jdc-cunningham/modular-pi-cam/README.md

### Modular Pi Cam

### Ver 2 (2.4in rectangle display)

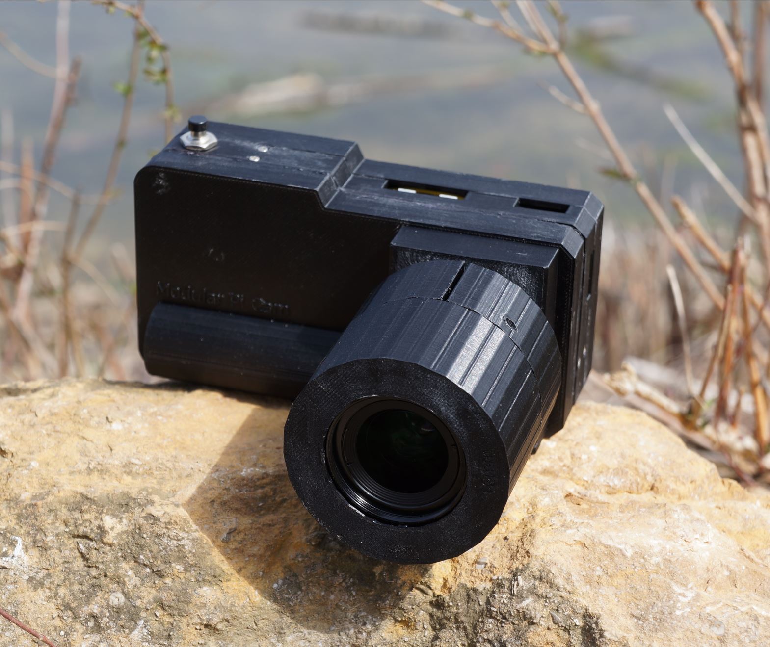
[picture p1: modular-pi-cam.JPG]


### Ver 1 (1.28 round display)

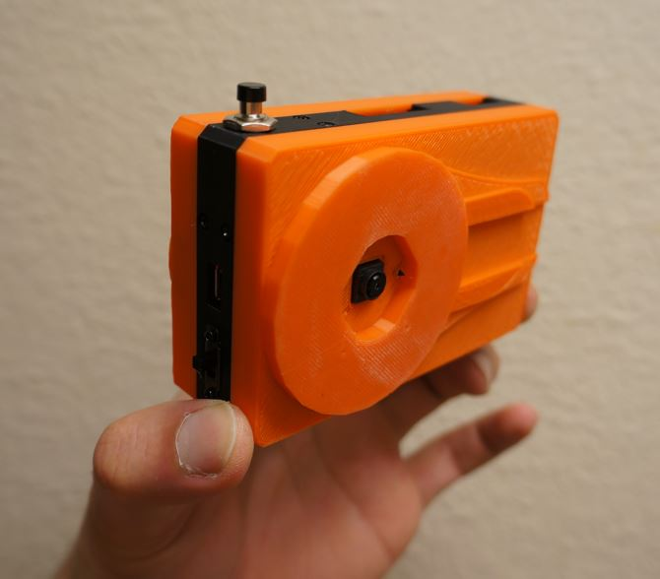
[picture p2: iso-front.JPG]


This version uses round display (non-touch) with 5D joystick

### Modularity

The center piece has changeable back and front plates
