jdc-cunningham/modular-pi-cam/cameras/pi-zero/large-display/README.md

### 2.4" LCD Display

Swappable cameras and body plates

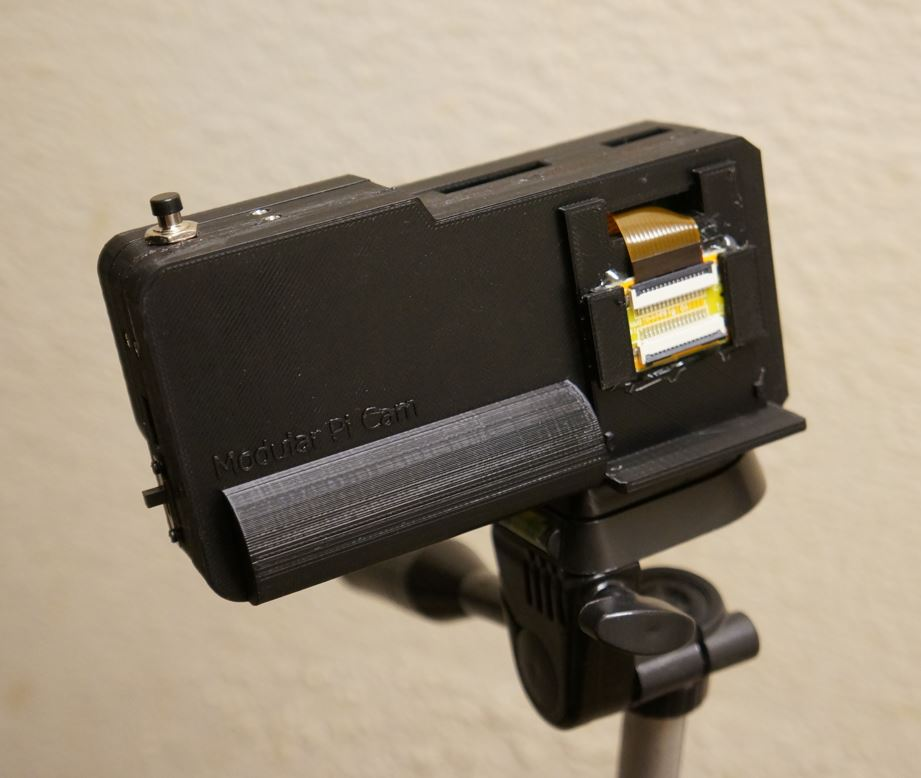
[picture p3: cameras/pi-zero/large-display/bridge-pin.JPG]


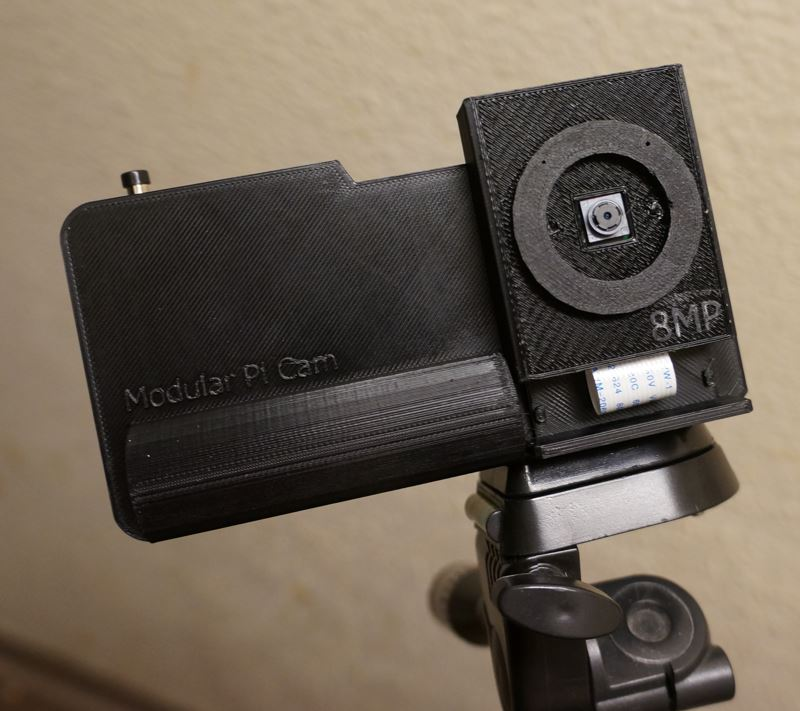
[picture p4: cameras/pi-zero/large-display/non-hq-cam.JPG]


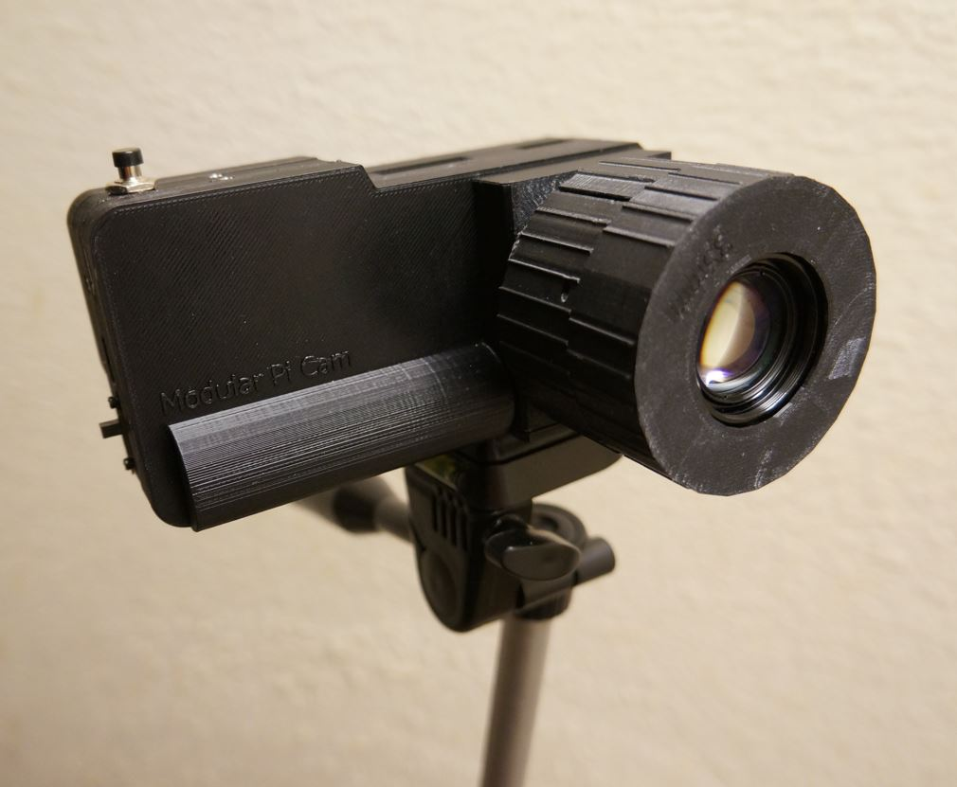
[picture p5: cameras/pi-zero/large-display/front.JPG]


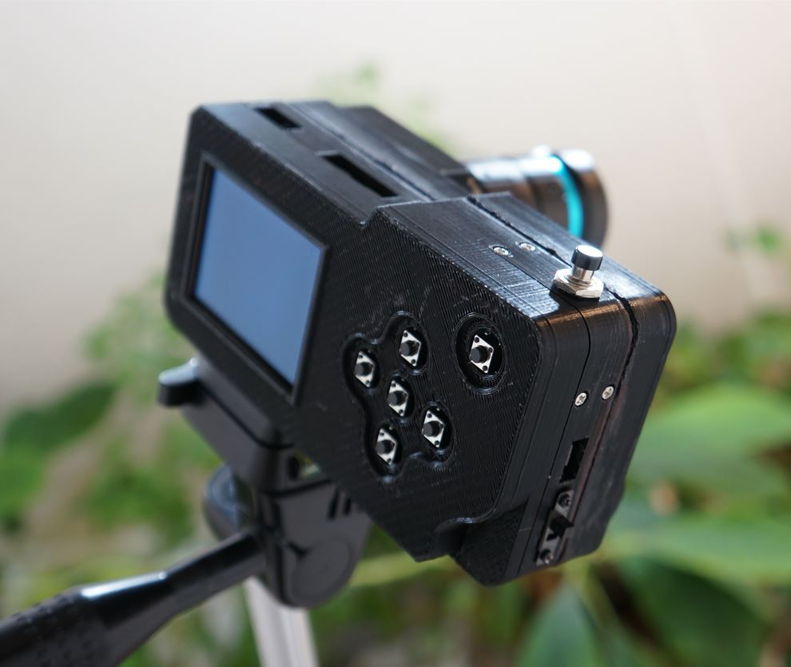
[picture p6: cameras/pi-zero/large-display/back-iso.JPG]
