jdc-cunningham/modular-pi-cam/cameras/pi-zero/pi-ro-cam/README.md

### Pi Ro Cam

Round display camera

Swappable body plates

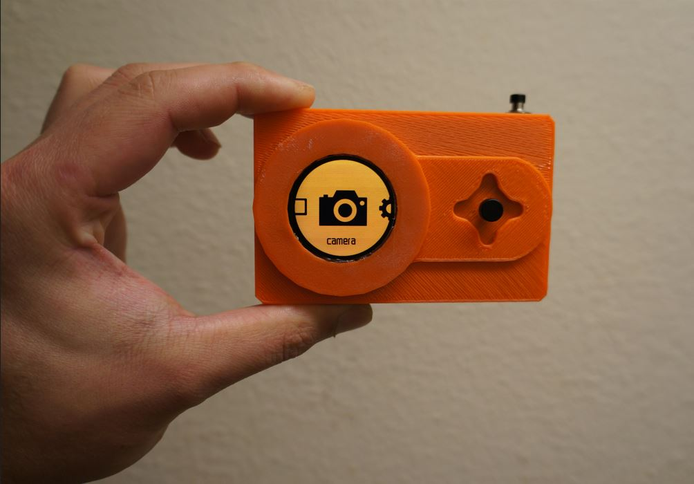
[picture p7: cameras/pi-zero/pi-ro-cam/modular-pi-cam-lcd.JPG]


### About

This was the first version, much smaller than the newer version that can swap camera modules vs. face plates.

The newer version is also much larger and features a tripod bolt screw mount.
