jdc-cunningham/modular-pi-cam/cameras/pi-zero/large-display/hardware/README.md

### Parts list

- raspberry pi zero 2 w
  - https://www.pishop.us/product/raspberry-pi-zero-2-w/
- raspberry pi hq cam
  - https://www.adafruit.com/product/4561
- 16mm telephoto lens
  - https://www.adafruit.com/product/4562
- DC-DC boost converter
  - [very long link](https://www.amazon.com/Converter-Adjustable-Voltage-Regulator-Compatible/dp/B089JYBF25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)
- 18650 battery
  - https://www.18650batterystore.com/products/panasonic-ncr18650b
- waveshare 2.4" LCD display
  - https://www.amazon.com/dp/B08H24H7KX?psc=1&ref=ppx_yo2ov_dt_b_product_details
  - https://www.waveshare.com/2.4inch-lcd-module.htm
- tactile button
  - https://www.amazon.com/gp/product/B07VSNN9S2/ref=ppx_yo_dt_b_search_asin_title?ie=UTF8&psc=1
- shutter button
  - https://www.amazon.com/gp/product/B09DJY5Y5L/ref=ppx_yo_dt_b_search_asin_title?ie=UTF8&psc=1
- 1 cell BMS/charger
  - https://www.amazon.com/gp/product/B00LTQU2RK/ref=ppx_yo_dt_b_search_asin_title?ie=UTF8&psc=1
- proto PCB board (cut to size)
  - https://www.amazon.com/gp/product/B072Z7Y19F/ref=ppx_yo_dt_b_search_asin_title?ie=UTF8&psc=1
- soft wire
  - https://www.amazon.com/gp/product/B01LH1G2IE/ref=ppx_yo_dt_b_search_asin_title?ie=UTF8&psc=1
- switch
  - https://www.amazon.com/gp/product/B01N235HVR/ref=ppx_yo_dt_b_search_asin_title?ie=UTF8&psc=1
- screws (used M1.7*6)
  - https://www.amazon.com/gp/product/B07HF46Q4R/ref=ppx_yo_dt_b_search_asin_title?ie=UTF8&psc=1
- otg usb
  - https://www.amazon.com/dp/B083WML1XB?psc=1&ref=ppx_yo2ov_dt_b_product_details
- usb mic
  - https://www.amazon.com/gp/product/B074BLM973/ref=ppx_yo_dt_b_search_asin_title?ie=UTF8&psc=1
- 15 pin extender for camera
  - https://www.amazon.com/gp/product/B07RWF4QCY/ref=ppx_yo_dt_b_search_asin_title?ie=UTF8&psc=1
- 15 pin type a cable needed for above
  - https://www.amazon.com/gp/product/B07RWTC13Q/ref=ppx_yo_dt_b_search_asin_title?ie=UTF8&psc=1

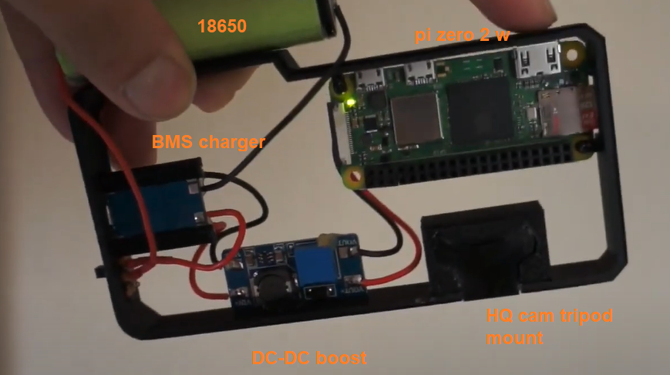
[picture p8: cameras/pi-zero/large-display/hardware/annotated.png]


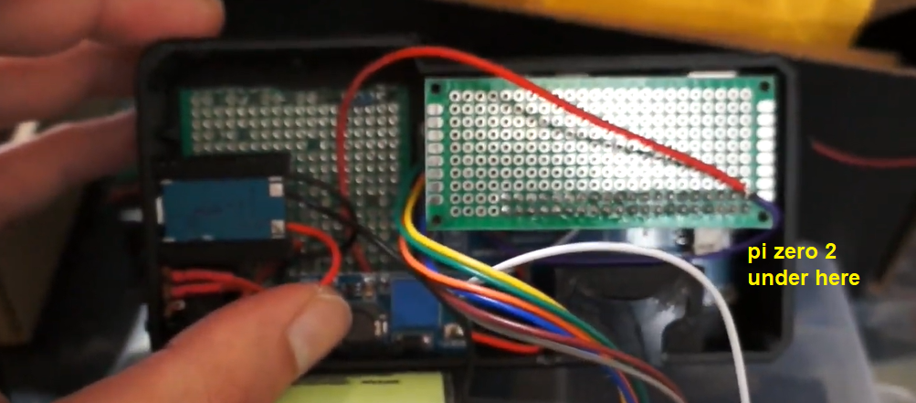
[picture p9: cameras/pi-zero/large-display/hardware/internals.png]
