jdc-cunningham/modular-pi-cam/cameras/pi-zero/pi-ro-cam/body/README.md

## Pi Ro Cam

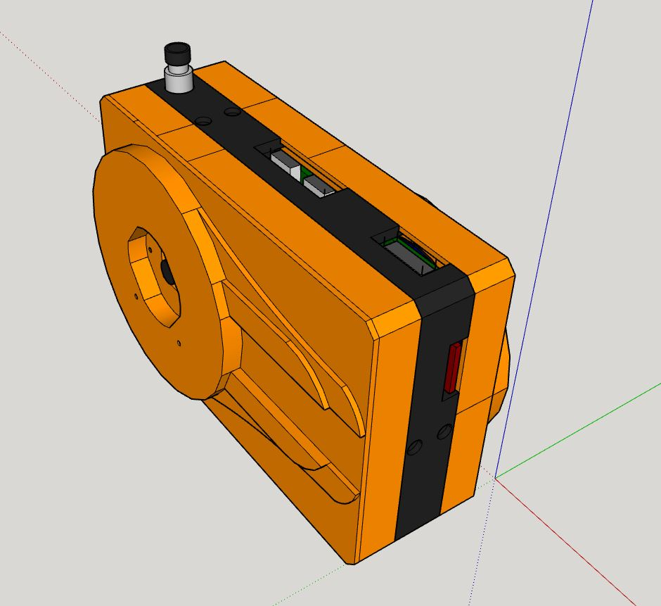
[picture p15: cameras/pi-zero/pi-ro-cam/body/iso.JPG]


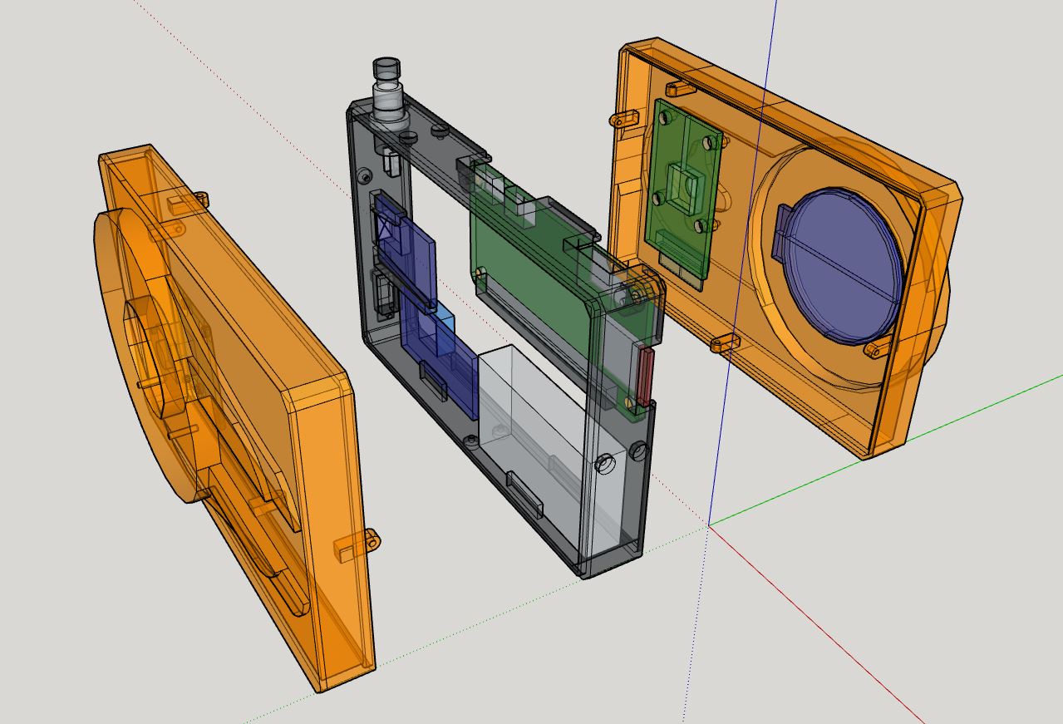
[picture p16: cameras/pi-zero/pi-ro-cam/body/exploded-xray.JPG]


### Print times

PLA 200C 50 mm/s 20% infill 1.75mm

- 2hrs 24mins middle body
- 3hrs 41mins back plate
- 4hrs 16mins v2 module front plate
