jdc-cunningham/modular-pi-cam/cameras/pi-zero/large-display/software/camera/README.md

### About

The Raspberry Pi HQ Camera has a 5.5 crop factor apparently so a 5mm CCTV lens is equivalent to 27.5mm full frame

picamera2 is primarily what is being used to do the live preview/photo taking
