jdc-cunningham/modular-pi-cam/cameras/pi-zero/large-display/software/FEATURES.md

### Implemented
- take auto setting photo
- take auto setting video
- crop-zoom pan (4x only)
- access IMU values (only 6050 part)
- demo file view
- battery estimator (software)

### Future
- manual camera settings
- dynamic battery icon (25%, 50%, 75%, 100%)
- crop-zoom pan (16x)
- redo menu organization/state management
- use IMU for horizontal overlay, maybe dead reckoning
- full working file view (background job to make thumbnails, pagination, individual view, delete)
- mobile app for bt file transfer/photo view on phone
- mobile remote shutter would be nice too
- astrophotography settings
