jdc-cunningham/modular-pi-cam/cameras/pi-zero/pi-ro-cam/modular-pi-cam-passthrough.JPG

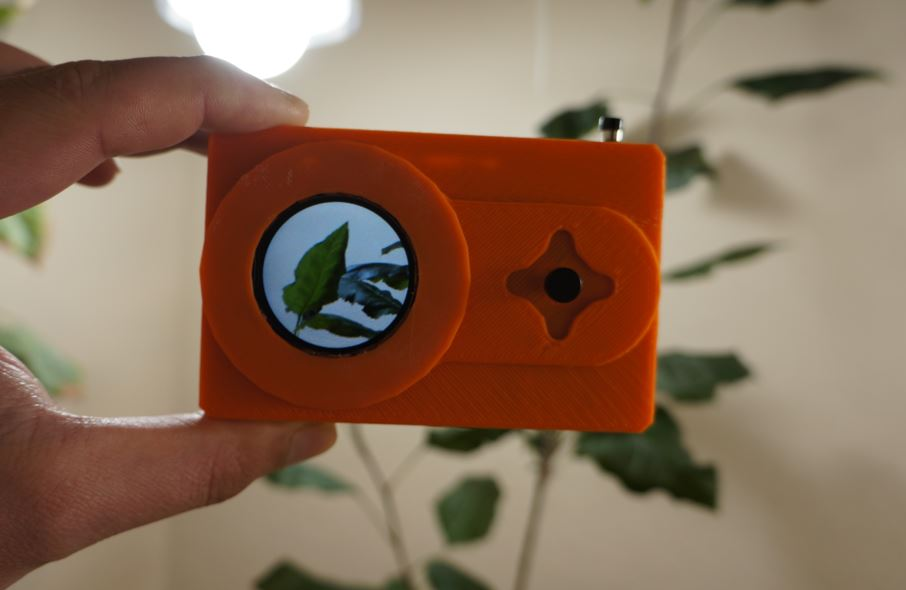
cameras/pi-zero/pi-ro-cam/modular-pi-cam-passthrough.JPG
