jdc-cunningham/modular-pi-cam/cameras/pi-zero/pi-ro-cam/software/display/pic/LCD_2inch4.jpg

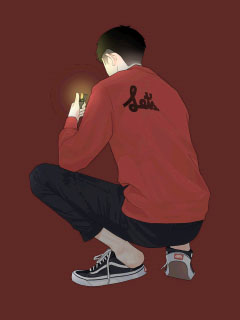
cameras/pi-zero/pi-ro-cam/software/display/pic/LCD_2inch4.jpg
