jdc-cunningham/modular-pi-cam/cameras/pi-zero/pi-ro-cam/software/menu/sprites/base-blue-gradient.png

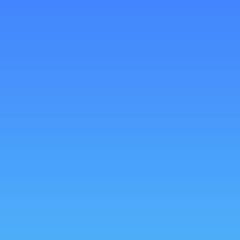
cameras/pi-zero/pi-ro-cam/software/menu/sprites/base-blue-gradient.png
