jdc-cunningham/modular-pi-cam/cameras/pi-zero/pi-ro-cam/software/menu/sprites/film_120_131.png

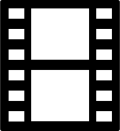
cameras/pi-zero/pi-ro-cam/software/menu/sprites/film_120_131.png
