jdc-cunningham/modular-pi-cam/cameras/pi-zero/pi-ro-cam/software/menu/sprites/settings_120_120.png

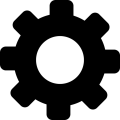
cameras/pi-zero/pi-ro-cam/software/menu/sprites/settings_120_120.png
