jdc-cunningham/modular-pi-cam/cameras/pi-zero/large-display/body/stls/usb-otg-cable-holder.stl

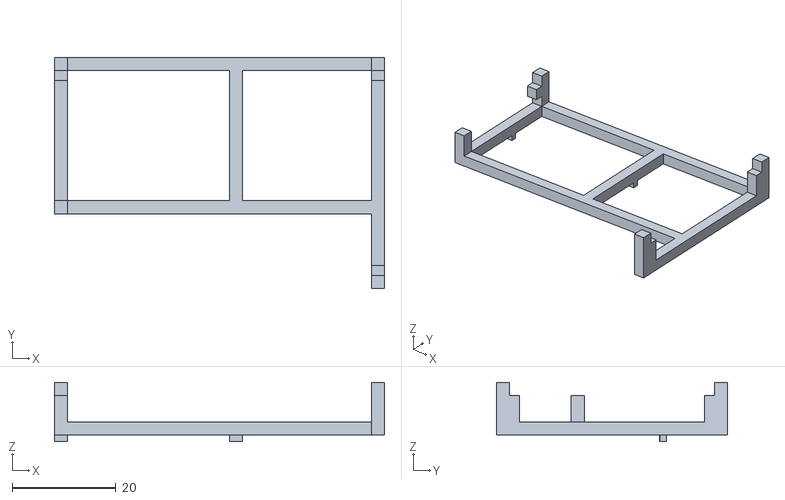
[picture p28: CAD file, 2024-06-11]
cameras/pi-zero/large-display/body/stls/usb-otg-cable-holder.stl
63.5 x 44.5 x 11.4
