jdc-cunningham/modular-pi-cam/cameras/pi-zero/pi-ro-cam/body/stls/back-plate-body.stl

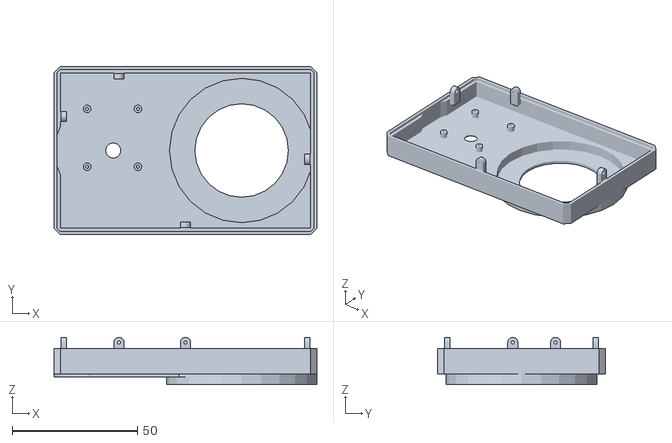
[picture p29: CAD file, 2024-03-14]
cameras/pi-zero/pi-ro-cam/body/stls/back-plate-body.stl
105.1 x 67.2 x 18.9
