jdc-cunningham/modular-pi-cam/cameras/pi-zero/large-display/body/stls/16mm-lens-cap.stl

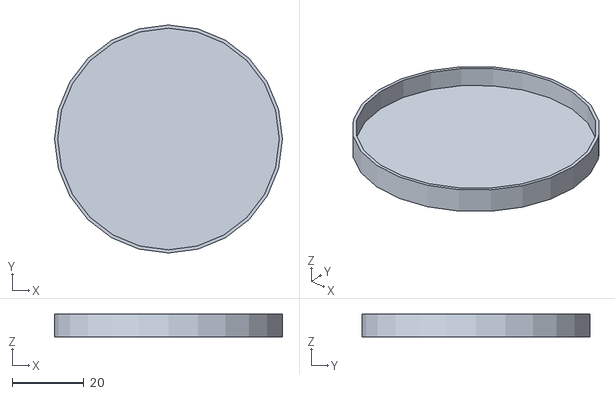
[picture p30: CAD file, 2024-03-27]
cameras/pi-zero/large-display/body/stls/16mm-lens-cap.stl
63.4 x 63.4 x 6.35
