jdc-cunningham/modular-pi-cam/cameras/pi-zero/pi-ro-cam/body/stls/front-plate-body-v2-cam-module.stl

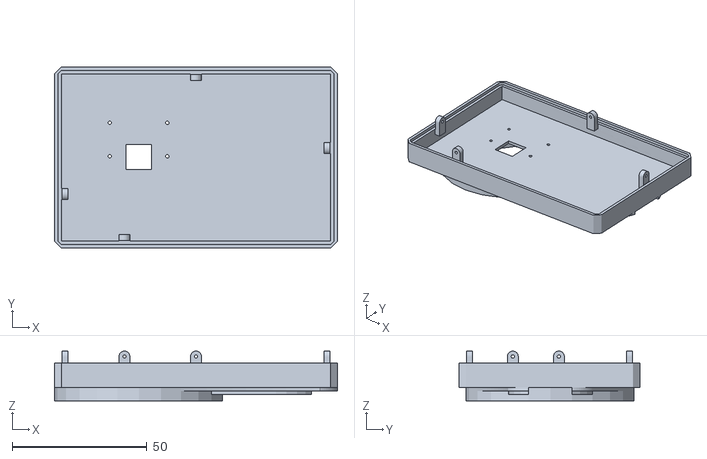
[picture p31: CAD file, 2024-03-14]
cameras/pi-zero/pi-ro-cam/body/stls/front-plate-body-v2-cam-module.stl
105.1 x 67.2 x 18.5
