jdc-cunningham/modular-pi-cam/cameras/pi-zero/large-display/body/stls/16mm-aperture-ring.stl

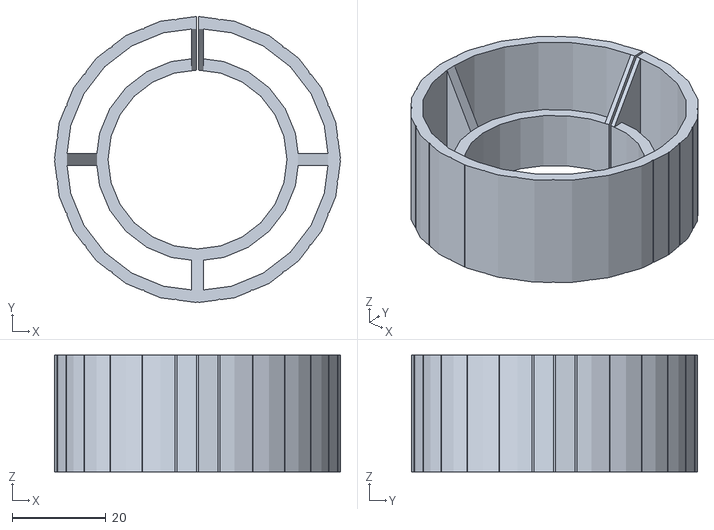
[picture p32: CAD file, 2024-03-27]
cameras/pi-zero/large-display/body/stls/16mm-aperture-ring.stl
60.9 x 60.9 x 24.9
