jdc-cunningham/modular-pi-cam/cameras/pi-zero/pi-ro-cam/body/stls/middle-body.stl

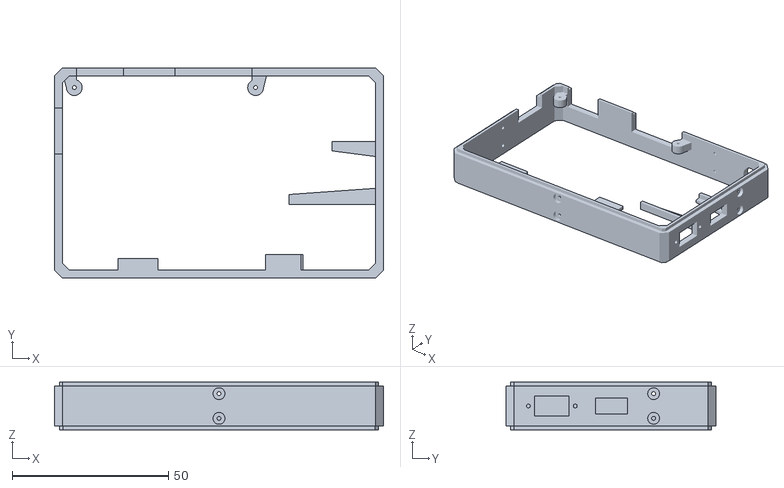
[picture p33: CAD file, 2024-03-14]
cameras/pi-zero/pi-ro-cam/body/stls/middle-body.stl
105.1 x 67.2 x 15.2
