jdc-cunningham/modular-pi-cam/cameras/pi-zero/large-display/body/stls/v3-module-cap.stl

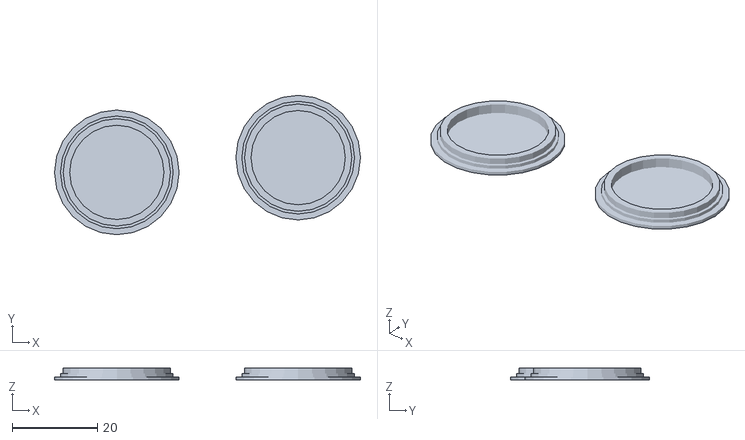
[picture p34: CAD file, 2024-03-27]
cameras/pi-zero/large-display/body/stls/v3-module-cap.stl
71.7 x 32.7 x 2.92
