jdc-cunningham/modular-pi-cam/cameras/pi-zero/large-display/body/stls/16m-focus-ring.stl

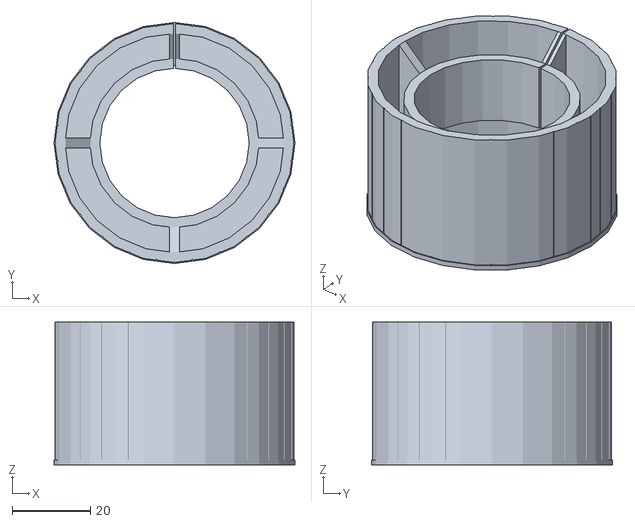
[picture p35: CAD file, 2024-03-27]
cameras/pi-zero/large-display/body/stls/16m-focus-ring.stl
61.5 x 61.5 x 36.5
