jdc-cunningham/modular-pi-cam/cameras/pi-zero/large-display/body/stls/v3-ring-slide-mount-top-plate.stl

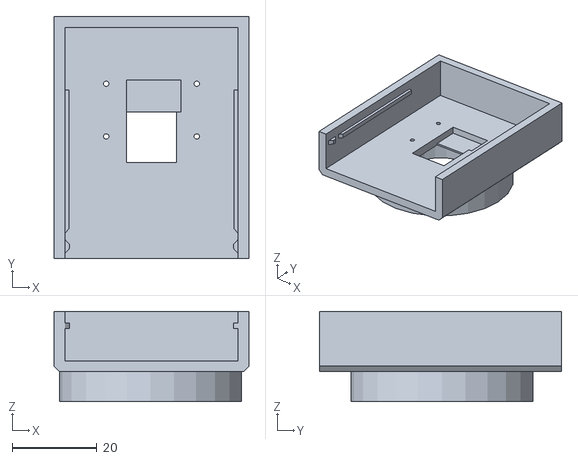
[picture p36: CAD file, 2024-03-15]
cameras/pi-zero/large-display/body/stls/v3-ring-slide-mount-top-plate.stl
46.0 x 57.2 x 21.3
