jdc-cunningham/modular-pi-cam/cameras/pi-zero/large-display/body/stls/front-plate.stl

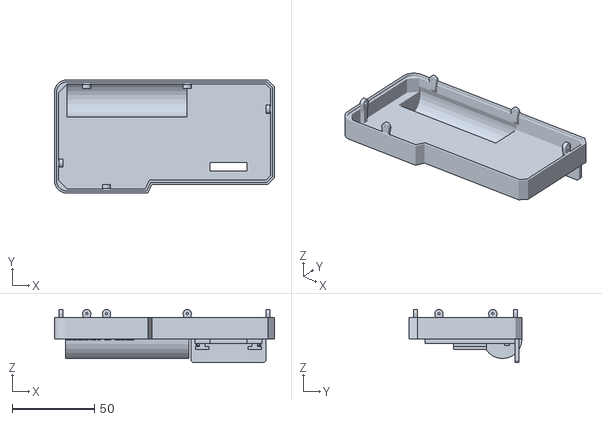
[picture p38: CAD file, 2024-03-14]
cameras/pi-zero/large-display/body/stls/front-plate.stl
133.5 x 68.6 x 32.3
