jdc-cunningham/modular-pi-cam/cameras/pi-zero/large-display/body/stls/back-plate.stl

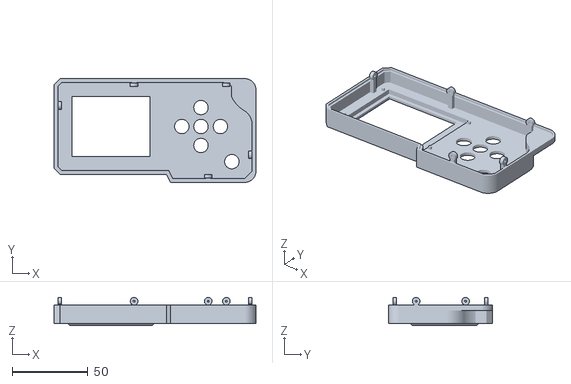
[picture p39: CAD file, 2024-03-14]
cameras/pi-zero/large-display/body/stls/back-plate.stl
133.5 x 68.6 x 18.7
