jdc-cunningham/modular-pi-cam/cameras/pi-zero/large-display/body/stls/d-pad-plate-test.stl

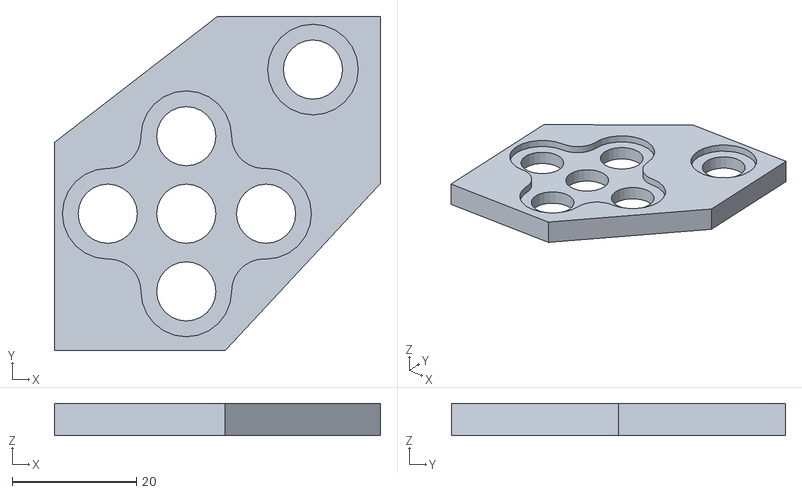
[picture p40: CAD file, 2024-03-14]
cameras/pi-zero/large-display/body/stls/d-pad-plate-test.stl
52.6 x 53.9 x 5.22
