jdc-cunningham/modular-pi-cam/cameras/pi-zero/large-display/body/stls/test-slide-mount-base-print.stl

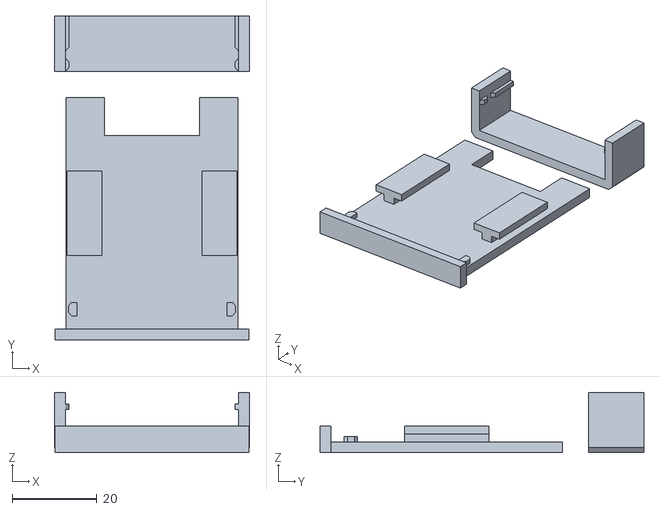
[picture p41: CAD file, 2024-03-14]
cameras/pi-zero/large-display/body/stls/test-slide-mount-base-print.stl
46.0 x 76.4 x 14.2
