jdc-cunningham/modular-pi-cam/cameras/pi-zero/large-display/body/stls/test-display-plate.stl

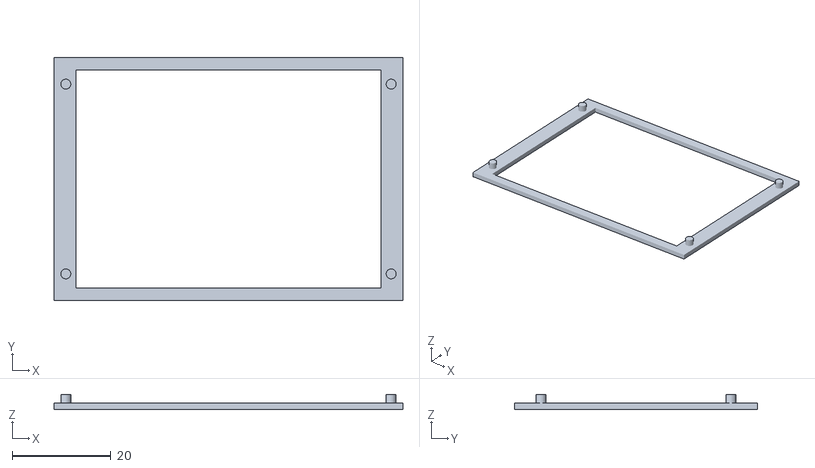
[picture p42: CAD file, 2024-03-14]
cameras/pi-zero/large-display/body/stls/test-display-plate.stl
70.8 x 49.4 x 3.00
