jdc-cunningham/modular-pi-cam/cameras/pi-zero/large-display/body/stls/test-slide-mount-top.stl

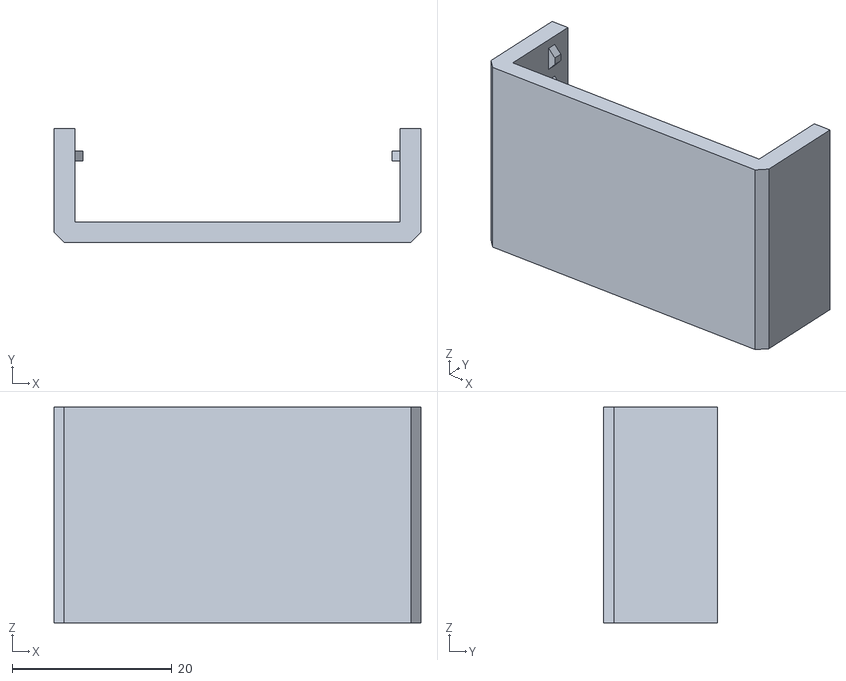
[picture p43: CAD file, 2024-03-14]
cameras/pi-zero/large-display/body/stls/test-slide-mount-top.stl
46.0 x 14.2 x 27.1
