jdc-cunningham/modular-pi-cam/cameras/pi-zero/large-display/body/stls/v3-slide-mount-top-plate.stl

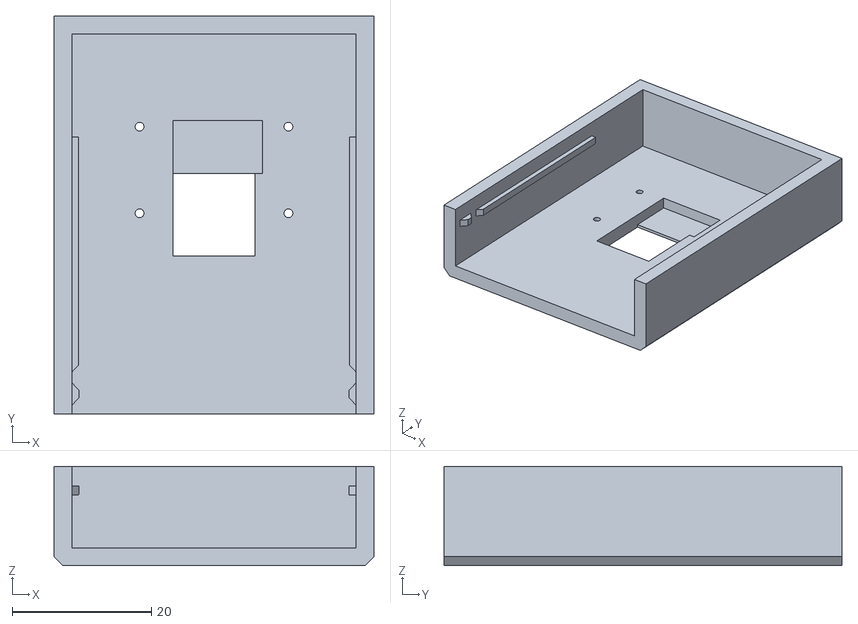
[picture p44: CAD file, 2024-03-14]
cameras/pi-zero/large-display/body/stls/v3-slide-mount-top-plate.stl
46.0 x 57.2 x 14.2
