jdc-cunningham/modular-pi-cam/cameras/pi-zero/large-display/body/stls/tripod-insert.stl

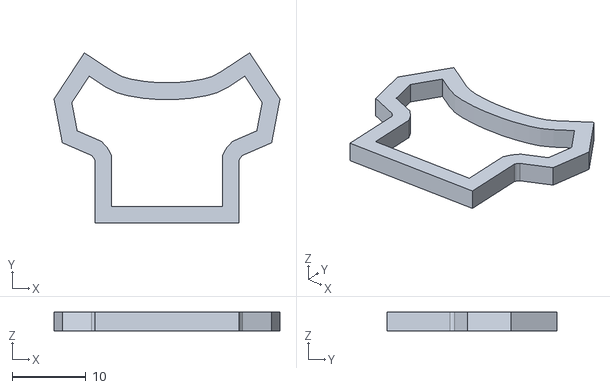
[picture p45: CAD file, 2024-03-14]
cameras/pi-zero/large-display/body/stls/tripod-insert.stl
30.6 x 23.1 x 2.54
