jdc-cunningham/modular-pi-cam/cameras/pi-zero/large-display/body/stls/middle-plate.stl

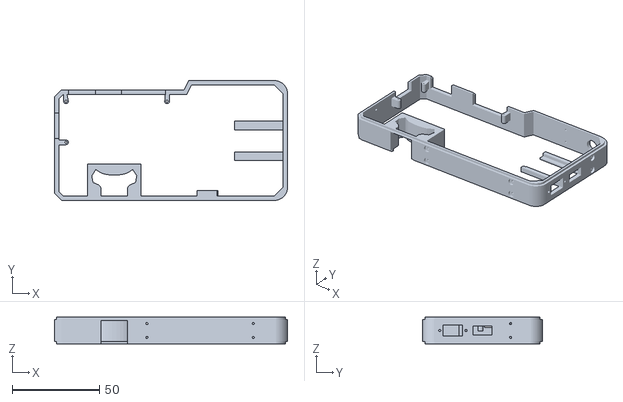
[picture p46: CAD file, 2024-03-14]
cameras/pi-zero/large-display/body/stls/middle-plate.stl
133.5 x 68.6 x 15.2
