jdc-cunningham/modular-pi-cam/(list of files, cad)

Other CAD files:
cameras/pi-zero/large-display/body/models/body-parts/back-plate.skp
cameras/pi-zero/large-display/body/models/body-parts/body-design.skp
cameras/pi-zero/large-display/body/models/body-parts/d-pad-plate-test.skp
cameras/pi-zero/large-display/body/models/body-parts/front-plate.skp
cameras/pi-zero/large-display/body/models/body-parts/middle-plate.skp
cameras/pi-zero/large-display/body/models/body-parts/slide-mount-top-plate-hq-cam.skp
cameras/pi-zero/large-display/body/models/body-parts/slide-mount-top-plate-v2-8mp.skp
cameras/pi-zero/large-display/body/models/body-parts/slide-mount-top-plate-v3.skp
cameras/pi-zero/large-display/body/models/body-parts/test-display-plate.skp
cameras/pi-zero/large-display/body/models/body-parts/test-slide-mount-base-print.skp
cameras/pi-zero/large-display/body/models/body-parts/test-slide-mount-base.skp
cameras/pi-zero/large-display/body/models/body-parts/test-slide-mount-top.skp
cameras/pi-zero/large-display/body/models/body-parts/tripod-insert.skp
cameras/pi-zero/large-display/body/models/body-parts/usb-otg-cable-holder.skp
cameras/pi-zero/large-display/body/models/body-parts/v3-module-cap.skp
cameras/pi-zero/large-display/body/models/lens/16m-focus-ring.skp
cameras/pi-zero/large-display/body/models/lens/16mm-aperture-ring.skp
cameras/pi-zero/large-display/body/models/lens/16mm-lens-cap.skp
cameras/pi-zero/large-display/body/models/parts/15-pin-connector.skp
cameras/pi-zero/large-display/body/models/parts/2.4-in-lcd-display.skp
cameras/pi-zero/large-display/body/models/parts/d-pad.skp
cameras/pi-zero/large-display/body/models/parts/rpi-hq-cam-tripod-mount.skp
cameras/pi-zero/large-display/body/models/parts/v3-camera-module.skp
cameras/pi-zero/large-display/body/stls/v2-slide-mount-top-plate.stl
cameras/pi-zero/pi-ro-cam/body/models/camera-body/back-half.skp
cameras/pi-zero/pi-ro-cam/body/models/camera-body/back-plate-body.skp
cameras/pi-zero/pi-ro-cam/body/models/camera-body/body-layout.skp
cameras/pi-zero/pi-ro-cam/body/models/camera-body/front-plate-body-v2-cam-module.skp
cameras/pi-zero/pi-ro-cam/body/models/camera-body/middle-body.skp
cameras/pi-zero/pi-ro-cam/body/models/camera-body/v3-camera-module-front-faceplate.skp
cameras/pi-zero/pi-ro-cam/body/models/parts/1-28-inch-round-lcd.skp
cameras/pi-zero/pi-ro-cam/body/models/parts/1s-720mah-lipo.skp
cameras/pi-zero/pi-ro-cam/body/models/parts/5-d-joystick.skp
cameras/pi-zero/pi-ro-cam/body/models/parts/5v-1a-charger.skp
cameras/pi-zero/pi-ro-cam/body/models/parts/8MP-camera.skp
cameras/pi-zero/pi-ro-cam/body/models/parts/dc-dc-boost-converter.skp
cameras/pi-zero/pi-ro-cam/body/models/parts/raspberry-pi-zero-w.skp
cameras/pi-zero/pi-ro-cam/body/models/parts/shutter-switch.skp
cameras/pi-zero/pi-ro-cam/body/models/parts/switch.skp
