jdc-cunningham/modular-pi-cam/cameras/pi-zero/large-display/software/test-code/menu/menu.jpg

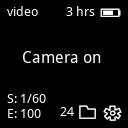
cameras/pi-zero/large-display/software/test-code/menu/menu.jpg
