jdc-cunningham/modular-pi-cam/cameras/pi-zero/large-display/software/test-code/menu/settings.png

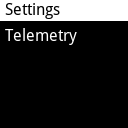
cameras/pi-zero/large-display/software/test-code/menu/settings.png
