jdc-cunningham/modular-pi-cam/cameras/pi-zero/large-display/software/test-code/oled/boot.jpg

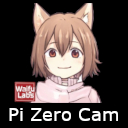
cameras/pi-zero/large-display/software/test-code/oled/boot.jpg
