jdc-cunningham/modular-pi-cam/cameras/pi-zero/large-display/software/test-code/oled/picture2.jpg

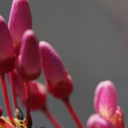
cameras/pi-zero/large-display/software/test-code/oled/picture2.jpg
