jdc-cunningham/modular-pi-cam/(threads)

Thread 6 (2024-03-27):

88% of the images failed to save!!!

jdc-cunningham, 2024-03-27:
You think you know how to write code?

Also got a flat tire today damn...

But look at how hot this is

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

jdc-cunningham, 2024-03-28:
Addressed here

https://github.com/jdc-cunningham/modular-pi-cam/pull/7

Closed 2024-03-28.

Thread 11 (2024-04-12):

Feat: USB transfer

jdc-cunningham, 2024-04-12:
Using micro usb OTG cable:

* auto detect it was plugged in
* menu option to transfer files
* move files with status of transfer

Unplug USB/mass storage and use with other OS eg. windows

jdc-cunningham, 2024-04-12:
So far I use Filezilla to transfer stuff.

This will carry over into the ML Clip Cam that made me think of this trying to transfer 1080P footage over SSH. It works but USB is something too.

jdc-cunningham, 2024-04-16:
Technically this is a flaw not having this. With SFTP/Filezilla you need to be on the same network between your PC and this camera to share images... there's no bluetooth feature yet (tried, BL vs. BLE issues) and the AP way needs work as well/locks you out of SSH.

So adding this feature is good.

jdc-cunningham, 2024-04-17:
Adding onto this:
- delete all files menu option
- charged option (manual vs. percentage)

jdc-cunningham, 2024-05-16:
adding to this microphone, did it on ml hat cam

jdc-cunningham, 2024-05-20:
Microphone addressed here

https://github.com/jdc-cunningham/modular-pi-cam/pull/14

jdc-cunningham, 2024-05-21:
Delete all files

https://github.com/jdc-cunningham/modular-pi-cam/pull/17

jdc-cunningham, 2024-05-21:
USB transfer

https://github.com/jdc-cunningham/modular-pi-cam/pull/18

Other issue of background process for video composition is in another issue

Closed 2024-05-21.

Thread 15 (2024-05-20):

Feat: monitor bg process video composition

jdc-cunningham, 2024-05-20:
The process of merging audio files then merging audio with video happens in a thread

Menu doesn't know it's happening

jdc-cunningham, 2024-05-22:
A thought here is to have an array of processing filenames...

However I just tried mutli-threaded and it results in segfault

jdc-cunningham, 2024-06-18:
https://github.com/jdc-cunningham/modular-pi-cam/pull/33

Closed 2024-06-18.

Thread 19 (2024-05-22):

Failed at park

jdc-cunningham, 2024-05-22:
Not sure what happened

I only had the mic connected

It was working for a bit

Even recorded a video past 1 min, but after that it just kept getting worse and worse

Till eventually it would not boot at all (show UI)

The SD card may have died?

jdc-cunningham, 2024-05-22:
I plugged an HDMI cable into it, was showing life/booting but then died

Plugged it in, thought it would have near full charge

jdc-cunningham, 2024-05-22:
I was developing on it today while it was plugged in... possible it was drawing too much/not really charging.

I let it charge a bit and it's booted fine. Will verify that it can record/merge files longer than a minute.

jdc-cunningham, 2024-05-22:
I'm using sandisk ultra gold so I don't think the SD card will die easily

jdc-cunningham, 2024-05-22:
I just recorded a 4 minute long video

It just ran out of power/could not stay on while processing, I can see a pattern in the files where it would no longer be able to produce the merged audio files/final mp4 file with sound, short recording, then just would not boot

Closed 2024-05-22.

Thread 20 (2024-05-22):

Not mounting the right USB drive

jdc-cunningham, 2024-05-22:
lol

jdc-cunningham, 2024-05-22:
Fixed here

https://github.com/jdc-cunningham/modular-pi-cam/pull/21

Closed 2024-05-22.

Thread 22 (2024-05-22):

Stops working

jdc-cunningham, 2024-05-22:
Yeah there is a problem with the background processing/order of things... whether it's a video file not being available or audio files

I will see about forcing the processing to block the camera for now until I can investigate that more. I'll just avoid recording videos much longer than a minute.

jdc-cunningham, 2024-05-22:
Yeah I already know what's wrong... since the background process is using a single instance of filename, when a new video starts while a background process is running, it loses that video-audio filename pairing... so I'll have to make that an object that gets removed after being processed hmm

and when it loses the filename pair/base it writes to the wrong folder (the `-#.wav` files)

see this video where I take a photo, then record a minute long video then start another one after

https://youtu.be/pjVsH7Oss_k

jdc-cunningham, 2024-05-22:
Easiest fix for now is to force one process at a time

Can still take photos but video recording can't happen until it processes last capture

Later I'll have to think about how to keep the pairings matched in the case of 3 things processing at the same time

jdc-cunningham, 2024-05-22:
I did a test a 1 minute video takes just over 30 seconds to process (with audio merging), maybe the fix is simpler than I thought where I can just pass the name through the function calls and the thread will keep the state

jdc-cunningham, 2024-05-22:
Trying to record a 3rd video while 2 are processing results in seg fault

hmm

jdc-cunningham, 2024-05-22:
Yeah I'm gonna rely on the single run and systemd service restarting itself on segfault for now till I deep dive into this

jdc-cunningham, 2024-05-29:
https://github.com/jdc-cunningham/modular-pi-cam/pull/25

Thread 30 (2024-06-05):

Issue: Fix bright colors

jdc-cunningham, 2024-06-05:
I posted about it on the raspberry pi forums, I was given a fix to try out

https://forums.raspberrypi.com/viewtopic.php?p=2227184#p2227184

Thread 31 (2024-06-06):

Feat: Astro photography

jdc-cunningham, 2024-06-06:
I did this with the Sony Alpha A7R3 before and some nice lenses

Gonna try with the HQ cam and 16mm telephoto... this lense because it has the highest resolving power eg. 10 MP

I'm doing this tonight (Thu)

Thread 36 (2024-07-02):

Issue: video to cam switch

jdc-cunningham, 2024-07-02:
It works fine if it's back to back video

But going from video to camera, the pass through doesn't show for camera, just white screen probably a state mismatch

Thread 39 (2024-08-27):

Encouragement and UPS Board

duracell80, 2024-08-27:
Just came across this project. I'm doing something similar to build an infrared digital camera.

Wanted to drop a note of encouragement to keep going and also this UPS board that would help simplify charging. It has an onboard led battery level indicator and power switch. Hold the power switch down to power off the unit. Press it to fire everything up from boot again.

Geekworm X306 V1.3 UPS Expansion Board for Raspberry Pi Zero 2W (Not Include Raspberry Pi&Battery) https://a.co/d/3c65ik1

jdc-cunningham, 2024-08-28:
Thanks for the links and suggestions

Yeah the LCDs unfortunately are dim in daylight it's a problem

That's a cool idea about reading the LED 25% power... yeah I think I need to put in a current shunt to really get a battery level

Lots of work to be done still but not in a point of life to put more effort into it unfortunately

Good luck with your project, feel free to post it here when it's done I wouldn't mind seeing it

Thread 40 (2024-08-28):

Sample Photos

jdc-cunningham, 2024-08-28:
I'll just fill this in as I take some that are noteworthy, here are a couple from recent photography sessions

I am still an amateur, not using manual settings

CGL 16mm
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

Sonew 5mm
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

jdc-cunningham, 2024-08-28:
I did try some night photography that needs work

16mm CGL
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

jdc-cunningham, 2024-09-03:
Took it out to a cool spot

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
