jdc-cunningham/modular-pi-cam/(commit log)

2024-03-14 reset repo
    [1-28-inch-round-lcd.skp, 15-pin-connector.skp, 1s-720mah-lipo.skp, 2.4-in-lcd-display.skp, 5-d-joystick.skp, 5v-1a-charger.skp, 8MP-camera.skp, back-plate-body.skp]
2024-03-15 update v3 plate design (#3)
    [slide-mount-top-plate-v3.skp, v3-ring-slide-mount-top-plate.stl]
2024-03-19 put switch on right part of wire (#4)
2024-03-27 Pi Zero HQ cam base code, 3D printed parts, update crop zoom pan and dynamic electronic aperture (#5)
    * bring in pi zero hq cam code
    * modify output for portrait LCD (from 128x128 to 240x320)
    * 16mm telephoto lens wrappers
    * update crop-zoom-pan code and add live preview overlay for dynamic electronic aperture
    * add lens cap for v3 module slide mounts
    [16m-focus-ring.skp, 16m-focus-ring.stl, 16mm-aperture-ring.skp, 16mm-aperture-ring.stl, 16mm-lens-cap.skp, 16mm-lens-cap.stl, v3-module-cap.skp, v3-module-cap.stl]
2024-03-28 Fix broken post photo state, photos not saving (#8)
    * update readme images
    * fix cron battery logger
    * reduce dupe code
    * fix bad live preview state
    * improve save rate of photos
    [camera.py, main.py]
2024-03-29 Switch to light mode (#9)
    * invert icon colors
    * update README img
    * light mode changes
    [OLED_Driver.py, display.py]
2024-04-03 Fix bug from lightmode, add failed to save check by size check (#10)
    * fix bugs from light mode change
    * add basic way of knowing photo failed to save
    [camera.py, display.py]
2024-05-06 Feat: live preview while recording video (#12)
    * use high-lo res stream encoder
    * add elapsed time overlay
    * change boot text
2024-05-15 Feat: add manual battery reset (#13)
    in settings
    [display.py]
2024-05-20 Feat: audio recording with video (#14)
    * usb device scanning for mic, mass storage
    * record 5 sec wav audio chunks
    * merge audio into video
2024-05-20 Doc: add demo files (#16)
    * test usb devices, recording
2024-05-21 Feat: transfer files to USB mass storage (#18)
    * mount usb, get usb storage info
    * file transfer with status
    * remove tasks file
2024-05-22 Fix: mount the drive everytime (#21)
    * remount drive
2024-05-29 Fix: audio recording segfault (#25)
    * always restart systemd unit
    * fix overflow UI for 3 digit files
    * force 1 video recording at a time while background renders (future fix is multi-process via array)
    * increase recording time and break loop (fixed sample length)
    * don't terminate pyaudio
    * handle mic being disconnected
    [camera.py, display.py]
2024-06-11 Feat: more USB mics and OTG USB adapter stand (#32)
    * add list of supported mics with annotated image
    * add usb fix to capture audio devices
    [usb-otg-cable-holder.skp, usb-otg-cable-holder.stl]
2026-03-31 Feat: Match layout for larger display and add basic photo viewer (#44)
    * changes to screen layout and add basic photo viewer
    [back-half.skp]
